RoboticaLLR/redmachine2024/other/photo_4913880098218814659_y.jpg

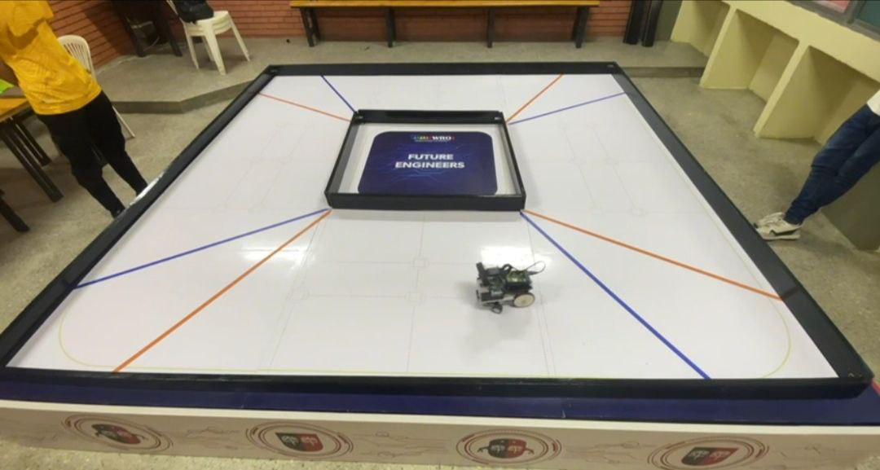
other/photo_4913880098218814659_y.jpg
