RoboticaLLR/redmachine2024/v-photos/Luka`s down.jpg

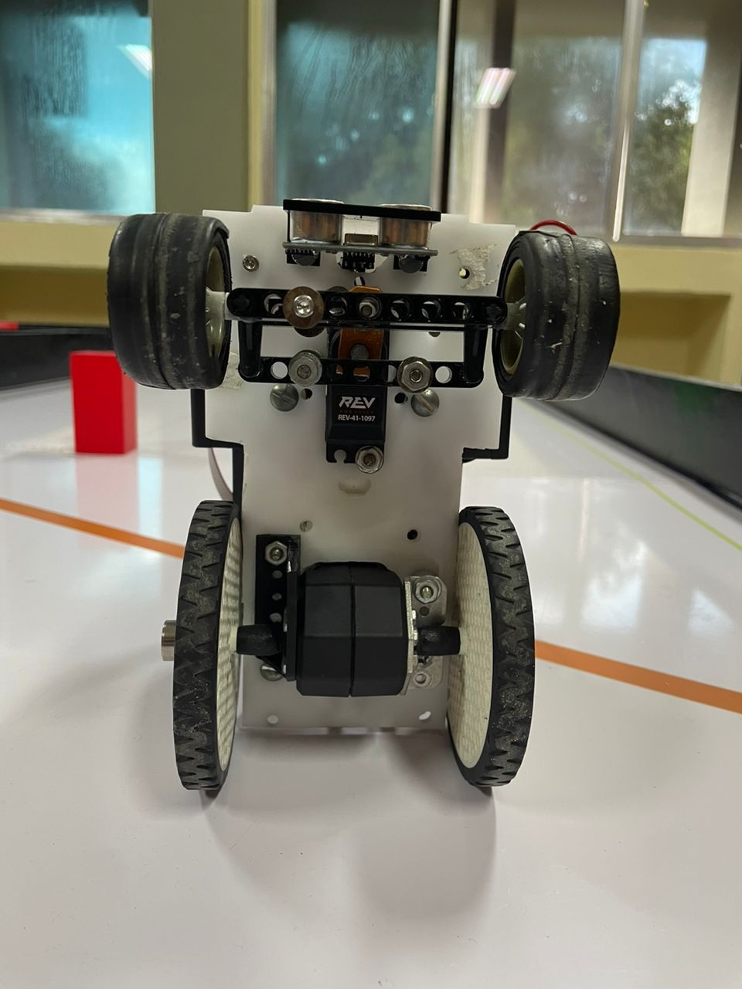
v-photos/Luka`s down.jpg
