RoboticaLLR/redmachine2024/README.md

# Engineering Documentation / Red Machine 

This repository contains all the materials necessary to create "Luka", the self-driving robot created by the "Red Machine" team, which will participate in the Future Engineers category at the World Robot Olympiad international final in the 2024 season.

Luka`s front

# Contents

 -  [Red Machine members](https://github.com/RoboticaLLR/redmachine2024/blob/main/README.md#Red-Machine-Members)
 -  [Introduction](https://github.com/RoboticaLLR/redmachine2024/blob/main/README.md#Introduction)
 -  [Mechanical design](https://github.com/RoboticaLLR/redmachine2024/blob/main/README.md#Mechanical-Design)
 -  [Software design](https://github.com/RoboticaLLR/redmachine2024/blob/main/README.md#Software-Design)
 -  [Mechanical Index](https://github.com/RoboticaLLR/redmachine2024/blob/main/README.md#Mechanical-Index)
 -  [Team history](https://github.com/RoboticaLLR/redmachine2024/blob/main/README.md#Team-History)

# Red Machine Members
-Samuel Jose Galban Franco

-Juan Diego Cano Barros

-Angel Saul Rodriguez Guerra

red machine 2024

# Introduction
We have done our best to make the best robot possible. It has been a very long road and learning programming, mechanics and design has helped us a lot. After much thought and analysis we have created our own strategy based on the electronic components we had, fervently believing that it will perform well in this edition of the WRO.

# Mechanical design
During the 2023 season, the design of the robot was always one of the biggest problems the team faced, this during all phases of the competition. The acrylic bases that were used in the first competitions did not work, since they had many imperfections, causing the traction and steering system to be poorly located, as well as a really bad distribution. Despite all this, that chassis gave us an idea of how to design a new one, so after the 2023 national competition, new acrylic bases were used, this time laser cutted. After this, the chassis looked really good in all aspects.

bases de acrilico pequeño

In addition, the robot's wheels were changed with new ones that held better to the steering system, which also provided better aesthetics to the robot.

After participating in the World Cup in Panama, the team decided to make important changes when creating the new prototype. 
Among these changes, the closer between the wheels of the traction and steering system stands out, with the aim of increasing the turning radius, allowing tighter turns. This mainly helps the development of the obstacle challenge, due to the difficulty of the challenge, and the strategy the team wishes to use.

Luka`s right
   
julian de lado 2024 2  

Likewise, the size of the robot was reduced by approximately 5 centimeters, helping the robot to be freer on the playing field, and making it easier to meet the challenges. To achieve this, the acrylics were redesigned, with the new ones having a completely different structure from the previous one.
acrilicos luka pequeño1

Another very important change was to redesign the steering system, which was again built with Lego pieces, coming from the spike prime robotics kit number 45678. 3 of these pieces were joined with a pair of wheels to finish its construction.

foto sistema direccion 1

In the same way, a 3D design was made, where we could see and efficiently analyze everything related to the robot.
### right
WhatsApp Image 2024-11-13 at 13 52 58_05e5de05
### Left
WhatsApp Image 2024-11-13 at 13 54 51_21982268
### Front
WhatsApp Image 2024-11-13 at 13 53 22_d6ef839f
### Back
WhatsApp Image 2024-11-13 at 13 52 30_cd6ade6e
### Above
WhatsApp Image 2024-11-13 at 13 55 55_4ce29d41
### Below
WhatsApp Image 2024-11-13 at 13 56 54_399b5e24

# Software Design

1. Image analysis
    -  [Image Processing](https://github.com/RoboticaLLR/redmachine2024/blob/main/src/Code.md#Image-Processing)
    -  [Color detection](https://github.com/RoboticaLLR/redmachine2024/blob/main/src/Code.md##Color-detection)
    - [Programming](https://github.com/RoboticaLLR/redmachine2024/blob/main/src/Code.md##Programming)
2. [Robot movement]
    - [Servo Determination](https://github.com/RoboticaLLR/redmachine2024/blob/main/src/Code.md#Servo-Determination)
    - [Orientation](https://github.com/RoboticaLLR/redmachine2024/blob/main/src/Code.md/#Orientation)
    - [Gyroscope Sideturns](https://github.com/RoboticaLLR/redmachine2024/blob/main/src/Code.md/#Gyroscope-Sideturns)
    - [First Challenge](https://github.com/RoboticaLLR/redmachine2024/blob/main/src/Code.md/#First-Challenge)
    - [Correction](https://github.com/RoboticaLLR/redmachine2024/blob/main/src/Code.md/#Correction)
    - [First Challenge parking](https://github.com/RoboticaLLR/redmachine2024/blob/main/src/Code.md/#First-Challenge-parking)
    - [Obstacle Challenge](https://github.com/RoboticaLLR/redmachine2024/blob/main/src/Code.md/#Obstacle-Challenge)
    - [Detection of Pillars](https://github.com/RoboticaLLR/redmachine2024/blob/main/src/Code.md/#Detection-of-Pillars)
    - [Movement through Orientation](https://github.com/RoboticaLLR/redmachine2024/blob/main/src/Code.md/#Movement-through-Orientation)
    - [Pillar avoidment First Lap](https://github.com/RoboticaLLR/redmachine2024/blob/main/src/Code.md/#Pillar-avoidment-First-Lap)
    - [Post-first sideturn](https://github.com/RoboticaLLR/redmachine2024/blob/main/src/Code.md/#Post-first-sideturn)
    - [Pillar storage](https://github.com/RoboticaLLR/redmachine2024/blob/main/src/Code.md/#Pillar-storage)
    - [Second and Third Lap Strategy](https://github.com/RoboticaLLR/redmachine2024/blob/main/src/Code.md/#Second-and-Third-Lap-Strategy)
    - [Next Pillar](https://github.com/RoboticaLLR/redmachine2024/blob/main/src/Code.md/#Next-Pillar)
    - [Sideturns](https://github.com/RoboticaLLR/redmachine2024/blob/main/src/Code.md/#Sideturns)
    - [Parking Obstacle Challenge](https://github.com/RoboticaLLR/redmachine2024/blob/main/src/Code.md/#Parking-Obstacle-Challenge)

## Electronic components
Arduino Mega 2560: Is a microcontroller board based on the ATmega2560. It has 54 digital input/output pins and 16 analog inputs, a 16 MHz crystal oscillator, a USB connection, a power jack, an ICSP header, and a rexset button. The arduino is the board that contains the code that allow luka to accomplish the challenge, using the sensors data to make the necessary movements.

mega 2560

H-bridge: It is a type of electrical circuit that allows changing the polarity of a direct current motor, forward and reverse. The H-Bridge model used is the L298N, which allows us to change the speed depending on the voltage sent by the Arduino.

puente H pequeño

Ultrasonic sensor: It is a sensor that uses ultrasonic sounds to detect the bounce time of sound from one side to the other. Using the Arduino Mega 2560 we can determine the distance based on the time it takes for the wave to return, performing the function of determining when there is a wall nearby, and thus making the corresponding turn.

HC-sr04

Giroscope: It is a sensor that measures the orientation of the robot in degrees. It is used to be able to do 90° turns and to avoid the traffic signs. 

BNO055

Pixy 2.1: it`s a camera that has saved values that correspond to the rgb colors of the traffic signs. Then the camera searchs for those values on the pixels of the image and, when a color is detected, pixy sends the data to the arduino to avoid the traffic signs. 

pixy2 1 2

Rev Robotics servo motor: An electric motor with an integrated position feedback sensor, which allows perfect angular movements to be made, using a signal that goes from 0V to 5V, where each value that the voltage may have represents an exact angle, fulfilling with excellence the function of performing the turns.

servo pequeño

Electric motor: A device that converts electrical energy into mechanical movement, allowing in this case to move a gearbox and mobilize the wheels. The speed and torque it has are determined by the voltage sent through the H-bridge, being moderated by the Arduino.

motor pequeño

The Arduino is powered by three 9v battery, which is turned on using a switch, and is responsible for feeding and giving the respective signals to the servomotor, so that it is able to make the crossings effectively with ease; the giroscope and two ultrasonic sensors, in addition to giving and receiving signals from the rest of the sensors. 

Lastly, the H-bridge is connected and powered by three 3.7v battery and is turned on with the same switch that turns on the Arduino.
The H-bridge receives signals from the Arduino that indacates to move the motor in different directions and speeds. It is also responsible for powering two ultrasonic sensors. 

# Luka Performance Videos 
 - [First challenge (ALL POSIBILITIES)](https://www.youtube.com/watch?v=auAgh7E2WA8)

(https://www.youtube.com/watch?v=auAgh7E2WA8)

 - [Second challenge practice](https://www.youtube.com/watch?v=cjjnRDXaDAU)

(https://www.youtube.com/watch?v=cjjnRDXaDAU)

# Mechanical index
For more information about the mechanics, we created a document where you can consult the specifications of the parts and mechanisms of the robot.

-  [Motors](https://github.com/RoboticaLLR/redmachine2024/blob/main/schemes/Mechanics.md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)
- [Sensors](https://github.com/RoboticaLLR/redmachine2024/blob/main/schemes/Mechanics.md#Sensors)
-  [Camera](https://github.com/RoboticaLLR/redmachine2024/blob/main/schemes/Mechanics.md#Camera)
- [Controller boards](https://github.com/RoboticaLLR/redmachine2024/blob/main/schemes/Mechanics.md#Controller-cards)
 - [Robot power](https://github.com/RoboticaLLR/redmachine2024/blob/main/schemes/Mechanics.md#Robot-power)
 - [Conexions diagram](https://github.com/RoboticaLLR/redmachine2024/blob/main/schemes/Mechanics.md#Conexions-diagram)

# Team history

1. 2023 Season
- [July 2023](https://github.com/RoboticaLLR/redmachine2024/blob/main/t-photos/History.md#July-2023)
- [August 2023](https://github.com/RoboticaLLR/redmachine2024/blob/main/t-photos/History.md#August-2023)
- [September 2023](https://github.com/RoboticaLLR/redmachine2024/blob/main/t-photos/History.md#September-2023)
- [October 2023](https://github.com/RoboticaLLR/redmachine2024/blob/main/t-photos/History.md#October-2023)
2. 2024 Season 
- [February 2024](https://github.com/RoboticaLLR/redmachine2024/blob/main/t-photos/History.md#February-2024)
- [March 2024](https://github.com/RoboticaLLR/redmachine2024/blob/main/t-photos/History.md#March-2024)
- [April 2024](https://github.com/RoboticaLLR/redmachine2024/blob/main/t-photos/History.md#April-2024)
- [May 2024](https://github.com/RoboticaLLR/redmachine2024/blob/main/t-photos/History.md#May-2024)
- [June 2024](https://github.com/RoboticaLLR/redmachine2024/blob/main/t-photos/History.md#June-2024)
- [October 2024](https://github.com/RoboticaLLR/redmachine2024/blob/main/t-photos/History.md#October-2024)
- [November 2024](https://github.com/RoboticaLLR/redmachine2024/blob/main/t-photos/History.md#November-2024)
3. Julian´s and Luka´s history 
- [JULIAN 1.0](https://github.com/RoboticaLLR/redmachine2024/blob/main/t-photos/History.md#JULIAN-1.0)
- [JULIAN 2.0](https://github.com/RoboticaLLR/redmachine2024/blob/main/t-photos/History.md#JULIAN-2.0)
- [JULIAN 3.0](https://github.com/RoboticaLLR/redmachine2024/blob/main/t-photos/History.md#JULIAN-3.0)
- [JULIAN 4.0](https://github.com/RoboticaLLR/redmachine2024/blob/main/t-photos/History.md#JULIAN-4.0)
- [JULIAN 5.0](https://github.com/RoboticaLLR/redmachine2024/blob/main/t-photos/History.md#JULIAN-5.0)
- [LUKA 1.0](https://github.com/RoboticaLLR/redmachine2024/blob/main/t-photos/History.md#LUKA-1.0)
- [LUKA 2.0](https://github.com/RoboticaLLR/redmachine2024/blob/main/t-photos/History.md#LUKA-2.0)
- [LUKA 3.0](https://github.com/RoboticaLLR/redmachine2024/blob/main/t-photos/History.md#LUKA-3.0)
