RoboticaLLR/redmachine2024/other/inside of the engine photo #1.jpg

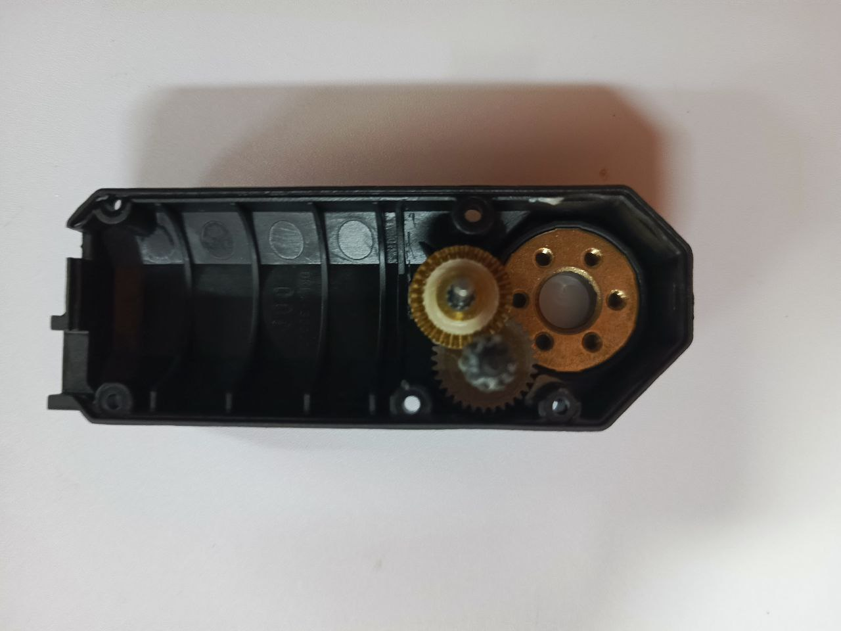
other/inside of the engine photo #1.jpg
