RoboticaLLR/redmachine2024/other/inside of the engine photo #2.jpg

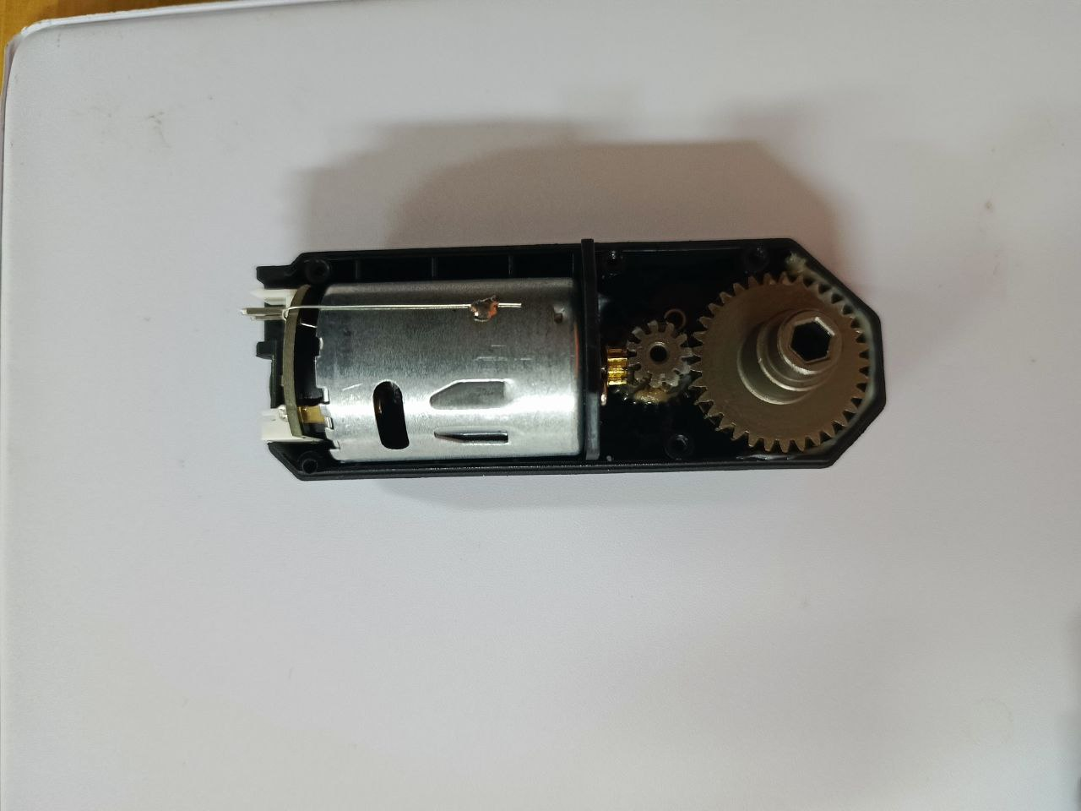
other/inside of the engine photo #2.jpg
