RoboticaLLR/redmachine2024/other/inside of the engine photo #3.jpg

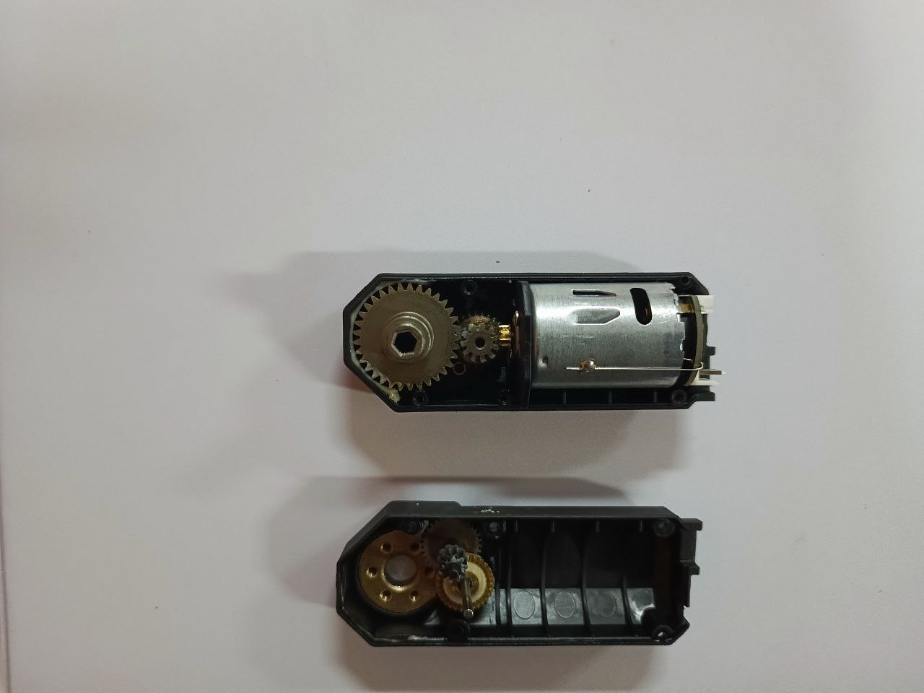
other/inside of the engine photo #3.jpg
