RoboticaLLR/redmachine2024/v-photos/Luka`s back.jpg

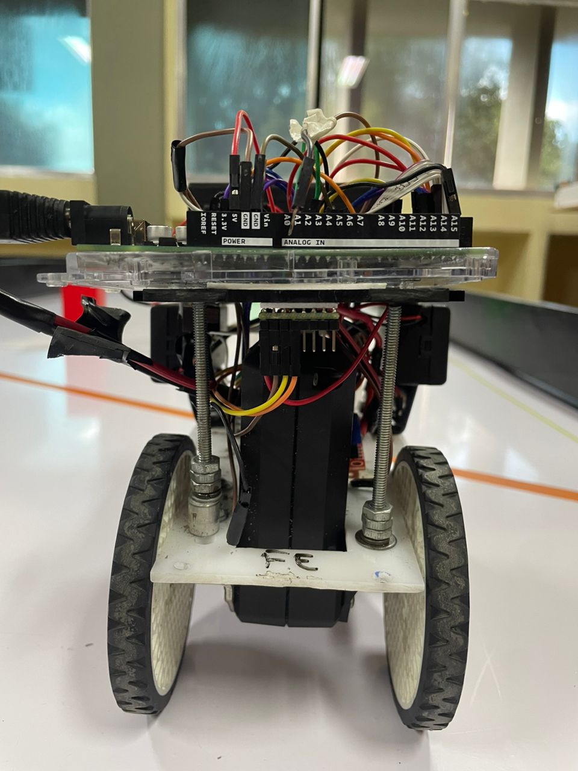
v-photos/Luka`s back.jpg
