RoboticaLLR/redmachine2024/v-photos/Luka`s front.jpg

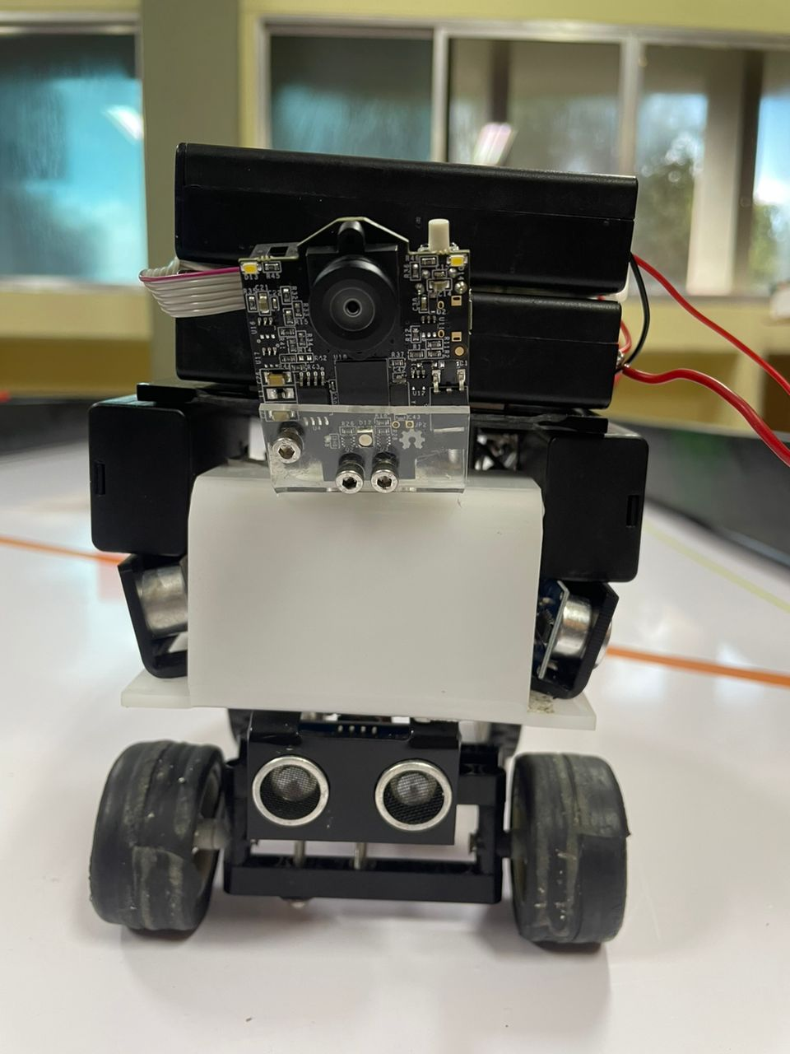
v-photos/Luka`s front.jpg
