RoboticaLLR/redmachine2024/v-photos/Luka`s left.jpg

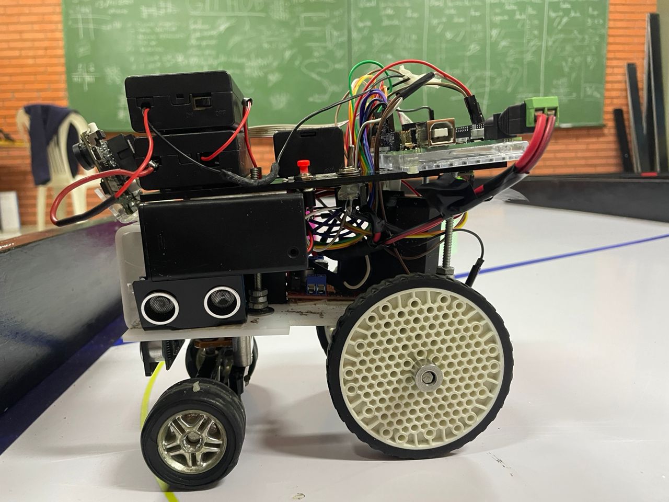
v-photos/Luka`s left.jpg
