RoboticaLLR/redmachine2024/v-photos/Luka`s right.jpg

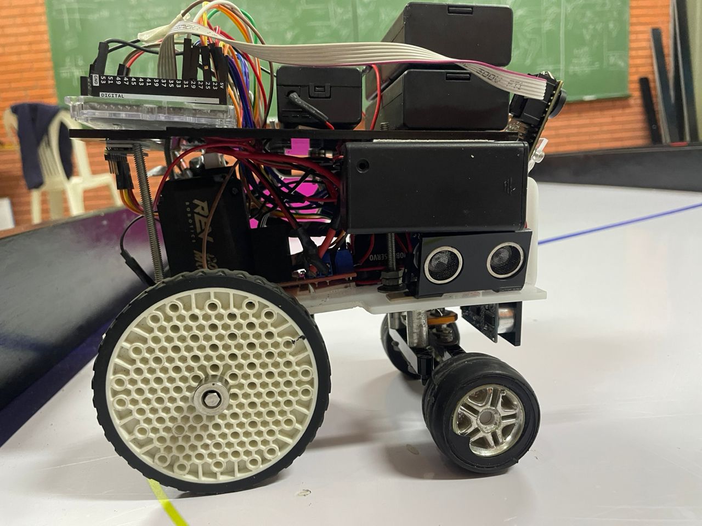
v-photos/Luka`s right.jpg
