RoboticaLLR/redmachine2024/v-photos/Luka`s top.jpg

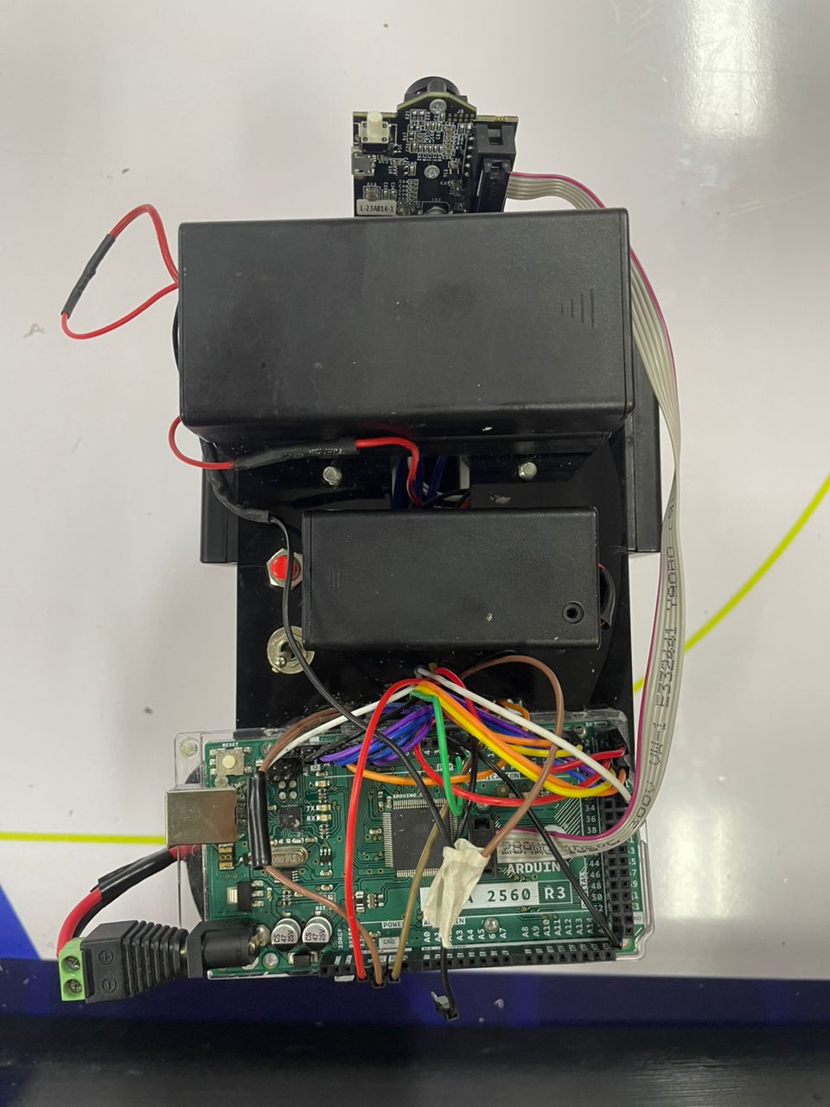
v-photos/Luka`s top.jpg
