RoboticaLLR/redmachine2024/models/Laser Cut.dxf

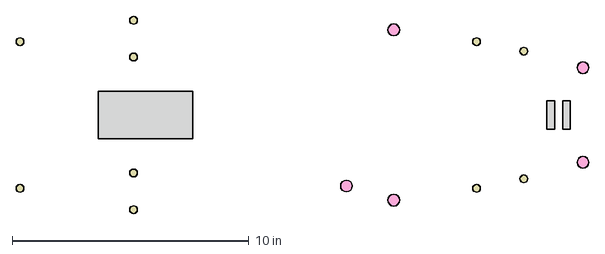
[picture p11: CAD file, 2024-04-25]
models/Laser Cut.dxf
24.2 x 8.33 in
