RoboticaLLR/redmachine2024/t-photos/History.md

# Read Machine history

1. 2023 Season
    - [July 2023](https://github.com/RoboticaLLR/redmachine2024/blob/main/t-photos/History.md#July-2023)
    - [August 2023](https://github.com/RoboticaLLR/redmachine2024/blob/main/t-photos/History.md#August-2023)
    - [September 2023](https://github.com/RoboticaLLR/redmachine2024/blob/main/t-photos/History.md#September-2023)
    - [October 2023](https://github.com/RoboticaLLR/redmachine2024/blob/main/t-photos/History.md#October-2023)
2. 2024 Season
    - [February 2024](https://github.com/RoboticaLLR/redmachine2024/blob/main/t-photos/History.md#February-2024)
    - [March 2024](https://github.com/RoboticaLLR/redmachine2024/blob/main/t-photos/History.md#March-2024)
    - [April2024](https://github.com/RoboticaLLR/redmachine2024/blob/main/t-photos/History.md#April-2024)
    - [May 2024](https://github.com/RoboticaLLR/redmachine2024/blob/main/t-photos/History.md#May-2024)
    - [June2024](https://github.com/RoboticaLLR/redmachine2024/blob/main/t-photos/History.md#June-2024)
    - [October2024](https://github.com/RoboticaLLR/redmachine2024/blob/main/t-photos/History.md#October-2024)
    - [November2024](https://github.com/RoboticaLLR/redmachine2024/blob/main/t-photos/History.md#November-2024)
3. Julian´s and Luka´s history 
    - [JULIAN 1.0](https://github.com/RoboticaLLR/redmachine2024/blob/main/t-photos/History.md#JULIAN-1.0)
    - [JULIAN 2.0](https://github.com/RoboticaLLR/redmachine2024/blob/main/t-photos/History.md#JULIAN-2.0)
    - [JULIAN 3.0](https://github.com/RoboticaLLR/redmachine2024/blob/main/t-photos/History.md#JULIAN-3.0)
    - [JULIAN 4.0](https://github.com/RoboticaLLR/redmachine2024/blob/main/t-photos/History.md#JULIAN-4.0)
    - [JULIAN 5.0](https://github.com/RoboticaLLR/redmachine2024/blob/main/t-photos/History.md#JULIAN-5.0)
    - [LUKA 1.0](https://github.com/RoboticaLLR/redmachine2024/blob/main/t-photos/History.md#LUKA-1.0)
    - [LUKA 2.0](https://github.com/RoboticaLLR/redmachine2024/blob/main/t-photos/History.md#LUKA-2.0)
    - [LUKA 3.0](https://github.com/RoboticaLLR/redmachine2024/blob/main/t-photos/History.md#LUKA-3.0)
    
## 2023 Seeason

### July 2023

After participating in a regional robotics competition, the team decided to participate in the WRO, specifically in Future Engineers; So as a first step, the team began to study and analyze the rules of the competition. 

1ra julio

The following days the team began to study what could be the first model of the chassis and investigated various ways to solve what would be the first problems that arose, which were how the steering system would be designed and what engine would be used to achieve the speed and torque needed.

2da julio

Next, the team began to look for engines that could be used, disassembling toys, printers, among other devices, to which the necessary engine was finally obtained by disassembling a remote control car model: Dodge T-rex Ram from the Nikko brand, which provided the necessary mechanical parts to design the steering system.

3rajulio 4julio

Subsequently, the team proceeded to assemble both systems, and the different devices that the robot would need on acrylic bases, and the first prototype of what would be the chassis was completed, and the programming area could continue.

5julio

For programming, an Arduino mega 2560 was used as a programmer, a double H-bridge as a power and speed regulator, and an ultrasound sensor to measure distance. Consecutively, the work team resumed the search for different solutions to detect the colors of traffic lights, deciding to use an ESP32-cam camera with an OV2640 lens, the next problem being how to program this with Arduino.

6julio

It was investigated what power source was going to be used to power the robot, because after using 9V batteries, the team realized that these were not ideal for the robot because they wear out in a very short time. Consequently, two battery packs ended up being joined, which had eight 1.2V rechargeable batteries in series, which finally added up to a total of 9.6V. 

Due to the space needed, a second prototype was designed in which it was decided to add a second floor to the robot, locating the electronics area in it, and the batteries, the traction system and the steering system on the first floor.

7julio

Without yet being able to solve the programming, it was decided to use a 34725 RGB sensor so that the robot detects in which direction it should cross.

8julio

A strategy is proposed: it is decided to cross with the color detection of the lines of the track, also using two more ultrasounds, one on each side of the robot, so that, once it detects a wall, it crosses to avoid a crash. However, these two ultrasounds did not mean help, but rather a problem, since, when they detected, the robot lost its trajectory, which is why it was finally decided not to use these two ultrasound sensors.

9julio

Before the competition, the team found rechargeable batteries with a higher voltage (3.7V), so it was decided to eliminate one of the two battery packs, and modify the remaining one so that it works with 3 batteries.

10julio

### August 2023

After participating in the first regional competition, the search for solutions to the problems presented began. It was decided to change the steering system, creating a new one with parts obtained in a spike prime robotics kit number 45678, since with this new steering system it would be possible to have a greater turning radius, as well as a more precise turn. 

1ago

New strategies were proposed, for which it was decided that the ideal way to cross would be with the help of ultrasound and that the TCS34725 sensor would only detect the first line to determine if the robot should cross clockwise or counterclockwise.

Continuing with the second part of the challenge, the team began to program the camera looking for how to transfer the information from the camera to the Arduino without needing to use Wi-Fi. After searching several sources, the solution was found, which was to transmit the information through serial ports.

Then the engine used for all this time began to fail very frequently, preventing the progress of the work team in the second challenge, so with a few days left before the competition the team removed the engine and therefore the gearbox from another Remote control car to attach to the robot.

2ago

To provide a greater turning radius the steering system was modified using pieces from a Lego Spike Prime Kit.

3ago

### September 2023

Practices were carried out on the track, for the robot's performance in challenge number one and two to do the best job in the 2023 national championship. The report was prepared and updated according to what had been achieved so far, and then carry out practices on the track, to improve the robot's performance in challenge number one and two for the 2023 national championship.

4ago 5 ago

The time has come for the national competition, in which the objective of qualifying for the 2023 WRO World Cup in Panama was achieved.

sep2sep1

### October 2023

The programming of the camera for challenge number 2 continued. Changing the wheels of the steering system to increase safety and aesthetics and the construction of the third prototype of the robot began, which is based on the restoration of the acrylics, organization of the cables through connectors to improve the aesthetic part of the robot.

sep3

The time for the World Cup arrives, in which the team was in the top 25 worldwide, and top 2 among Latin American countries.

oc1oct2

## 2024 Season

### February 2024

The first thing the team did to start this season was study the new rule manual, to find the differences in the challenge and think about possible strategies for the new year.

febrero 1

The team began to design the new robot, taking into account everything learned at the World Cup. During this design, aspects such as size, weight, which components would be used, their position and the distance between the traction and steering systems were taken into account.

feb2

The team continued to think about what strategy to use. With the aim of not showing the advances and improvements that would be made in the new robot, it was decided that the best thing would be to participate again with Julián (robot of 2023) during the regionals, and participate with the new robot (Luka) in the national, which would be the greatest challenge of the moment.

feb3

### March 2024

During this month, the construction of the robot that will be used in the 2024 national competition began. In the first week of March, the acrylic bases were cut, and the missing components for the robot were purchased.
First, the traction system and the steering system were installed on the robot. At this time the steering system was constructed of 3 pieces of acrylic.  After this the arduino and raspberry were installed.

feb4feb5

At the end of March, the construction of the robot was completed, after installing all the sensors that the robot would use. Likewise, programming for challenge 1 began, and python programming for challenge 2.

feb6

### April 2024

Since the team decided to participate with Julián in the regionals, work began on some improvements for the operation of this robot. One of these improvements was the change from the 34725 RGB sensor to the TCS 3200 color sensor.

feb7

With a view to the regional one that was approaching, the report was updated according to what had been achieved so far. The most important in this regard was the update of the chronology, the wiring diagram and the specifications of the color sensor.

feb8

2024 regional competitions:

Colegio Santo Tomás de Aquino 04-05-2024
feb9

### May 2024
Liceo Los Robles 18-05-2024
feb10

### June 2024

Looking ahead to the national, the team continued with the tests of both challenges, mainly the second; At the same time, the team made Luka's report.
During the tests, it was decided to remove the color sensor since it was not working in the best way, and the ultrasound sensors on the sides began to be used to know which side Luka should follow.

jun1

The team managed to completely finish the report, and finished uploading the information to GitHub at the end of the month, being already prepared for the WRO 2024 national.

JUN2 JUN3

### October 2024

After winning the national competition, the team got to form part of the delegation that will represent Venezuela on the world robot olympiad internacional final, on izmir, Türkiye. For this, the team needed a lot of preparation and practice, so they started to work on Luka. 

On the first two weeks of preparation the team started to make structural changes on Luka, looking to make the robot smaller. To accomplish this, both the traction and direction system where moved. The direction system got turned 180 degrees for the wheels to be more on the front, and the motor of the traction system changed it’s position to be vertical, using less horizontal space. After this, there were around 5cm of dead space on the robot’s back that were cutted, finishing this process with the robot measuring 18cm. 

motor comparation
Traction comparation

The third week of work was the start point of programming. After having problems with the raspberry pi supply power, the team decided to search for a new way of detecting the traffic signs. After searching for a solution, the team decided to use a pixy cam because of it using less space, weighting less, and been able to power with the arduino. The team also realized that a giroscope would be needed, specially on the second challenge, so they started to use the HMS5883L magnetometer. 

pixy2 1
HMC5883L

The pixy cam resulted as an exellent choice, but the magnetometer was not, so the team started to find a new one, picking MPU6050. After a lot of practice with the accelerometer the team got to use it on the full turns, but because of large error margin the could not trust it to take the car to turn at exactly 90 degrees. 

prueba pixy
MPU6050

Because of this the team used the fourth week to design a new strategy. On this new strategy the robot caribrated with the exterior walls. 

### November 2024

The first week of november was purely preparation and practice. On this week the robot got to do two consistent laps on the second challenge, but the team was still worried about the giroscope problem. 

ramdom practice

Because of this, on the second week of november the team started to practice with a new giroscope, the BNO055. This sensor is an hibridation of a magnetometer and an accelerometer, allowing it to give an almost exact data. 

BNO055

## Julian´s and Luka´s history 

### JULIAN 1.0

Primer Julian

### JULIAN 2.0

segundo julian

### JULIAN 3.0

Tercer Julian

### JULIAN 4.0

Cuarto Julian

### JULIAN 5.0

Quinto Julian

### LUKA 1.0

Primer Luka

### LUKA 2.0

Segundo Luka

### LUKA 3.0

Luka`s right
