RoboticaLLR/redmachine2024/(commit log)

2024-04-25 Delete schemes/Schematic Diagram.png
    Se colocará el nuevo diagrama de conexiones
2024-04-25 Add files via upload
    Se añade el nuevo diagrama de conexiones
2024-04-26 Update README.md
    Cambiamos el read me al lenguaje espanol
2024-04-26 Update README.md
    Arreglo de ultimos detalles al read me
2024-06-25 Version 2 cambio en la explicacion
    Se agregaron cosas y se modifico el readme
2024-06-25 rehacer el ultimo commit
2024-06-25 Arreglo de errores version 2
2024-06-27 Realizamos el readme de historia
    hicimos el readme de historia y cambiamos partes de los anteriores de readme para favorecer su lectura
2024-06-27 Agregamos la historia al readme principal
2024-06-28 Creamos el documento Mecanica, y lo agregamos al readme
2024-06-28 Agregar el indice en el readme
2024-07-03 Pusimos dentro del repositorio todas las fotos
    pusimos todas las fotos del repositorio y incluimos cosas tales como el codigo y las fotos
2024-07-04 Modificamos el readme
    Incluimos el vide del reto 1 y reto 2 e igualmente cambiamos el readme principal para facilitar la lectura de los jueces
2024-07-06 Agregramos nuevas variantes de videos
2024-07-08 Incluimo una carpeta con todo el github traducido al ingles
2024-07-10 modificamos la estructura
    Cambiamos parte de como estan distruibuidos los archivos en el respositorio para poder encontrar las cosas mas facilmente
2024-11-11 New changes to Luka
    All the repository has been translated, the raspberry pi information has been eliminated, the cronology has been updated and the giroscope was added to sensors
2024-11-13 Strategy and camera added
    There is now a full strategy description and all the camera and the color detection information has been added
2024-11-28 Second challenge code has been actualized
    A new function has been added so that the robot really turns at 90 degrees, using the PID formula
